james-pankiw/mren403-group10-portfolio-i/README.md

# MREN 403 Group 10 — Engineering Portfolio I

UAV launch for MakeFlyEasy Fighter on Zodiac Nautic PRO 7.  
Supervisors: Jonathan Gammell, Melissa Greeff.

**Start here:** `problem-definition.md` → `decisions/subsystem-validation.md` → `experiments/` → `design/`.

| Folder / file | Contents |
| --- | --- |
| `problem-definition.md` | Problem definition |
| `decisions/` | Validation plan, roles |
| `design/` | Subsystem design packages |
| `experiments/` | Wave / pitch simulation write-ups and plots |
| `references/` | Fighter and PRO 7 sources |
| `deliverables/` | Proposal PDF |
