james-pankiw/mren403-group10-portfolio-i/design/README.md

# Design

Folders match launcher subsystems. See `decisions/subsystem-validation.md` for what the prototype tests.
