james-pankiw/mren403-group10-portfolio-i/design/pitch-gate/README.md

# Pitch gate

Sensing, forecast, allow/refuse for launch on a pitching boat.

## Sears framing

Thomas Sears’s work on wave-driven boat motion (Queen’s / Marshall lab) sits behind the gate design. Chapter 4 of his thesis gives a short-horizon pitch forecast as a **time-only spectral mixture**. Our sims use that as two cosines fitted to recent pitch, which beats a naive rate-hold over a ~0.3 s rail window. Field IMU logs and Sears’s full wave-modelling code are still separate from what we run here.

## Artifacts

| File | Role |
| --- | --- |
| `pitch_sine_sim.py` | Two-cosine forecast vs rate hold |
| `pitch_gate_demo.py` | Interactive boat / scope / arm demo |
| `../../experiments/wave-pitch-simulation.md` | Write-up |
| `../../experiments/pitch-forecast-v2.1.png` | Forecast figure |

## Reference

Sears, T. M. C. (2026). *Spectral Analysis for Robotic Spatiotemporal Mapping* (Ph.D. thesis, Chapter 4). Queen’s University. https://queensu.scholaris.ca/items/ed41fb5e-f0e1-4573-935c-7e94e8f48fed
