james-pankiw/mren403-group10-portfolio-i/design/rails-structure/README.md

# Rails / structure

| File | Role |
| --- | --- |
| `Prototype Rails.docx` | Acrylic / PLA / Sasco strut trade → strut bed for the **prototype** |
| `Full Sized Rail.docx` | CNC aluminum vs stainless → **stainless** for full-size |

Prototype strut tests structure stability only; they do not lock full-size material.
