james-pankiw/mren403-group10-portfolio-i/design/carriage-release/README.md

# Carriage & release

Hold / brake / gripper clear for the rail launch axis.

| File | Role |
| --- | --- |
| `insitu-carriage.md` | Insitu SuperWedge concept → what we adopt for hold / brake / clear |

Prototype uses a football as fuselage stand-in. CAD and gripper detail still TBD.
