james-pankiw/mren403-group10-portfolio-i/design/launch-energy/README.md

# Launch energy

Band sizing and selection for the rail launch axis.

| File | Role |
| --- | --- |
| `Launcher Band Calculations.docx` | Energy / band sizing |
| `Launcher Band Decision.docx` | Band choice and rationale |
