james-pankiw/mren403-group10-portfolio-i/decisions/group-leads.md

# Group leads

MREN 403 Group 10. Technical ownership for design, prototype validation, and report sections.

| Lead | Heads |
| --- | --- |
| **James Pankiw** | Wave prediction; sensing; electronics (IMU, Pi, logging, wiring); report section on prediction/electronics |
| **Darcy Ryan** | Rails, frame, carriage structure; boat mount interface |
| **Ahrvin Raveendran** | Launch dynamics; energy delivery (bands/latch loads); actuation |
| **Jamison McCulloch-Cop** | Pitch stabilization; **CAD modelling for the final (full-size) design** |
