james-pankiw/mren403-group10-portfolio-i/references/fighter-hand-throw.md

# MakeFlyEasy Fighter, hand-throw

Copied 2026-10-07 from the manufacturer page: https://en.makeflyeasy.com/index.php/fighter-hand-throw/

The page is the source. A manual is still not in the repo. Do not fill launch speed, empty mass, or an acceleration limit from anywhere else without a citation.

## Stated on the page

| Item | Value |
| --- | --- |
| Layout | Conventional fixed-wing, hand-throw version |
| Material | EPO, EVA, carbon fiber, engineering plastics, etc. |
| Wingspan | 2430 mm |
| Fuselage length | 1450 mm |
| Fuselage height | 180 mm |
| Wing area | 72.5 dm² |
| Disassembly | Tool-less |
| Load compartment | 280 × 160 × 110 mm |
| Transport box | 1.25 m × 0.34 m × 0.49 m |
| Max. takeoff weight | < 7 kg |
| Max. payload | 1.5 kg |
| Take-off and landing | Hand-throw; parachute landing or slide landing |
| Practical lift height | 4000 m |
| Wind resistance | 50km (the page does not write km/h) |

## Useful conversions

These are arithmetic on the table above, not extra manufacturer data.

- Wing area 72.5 dm² = 0.725 m².
- At the takeoff-weight limit, wing loading is under \(7 / 0.725 \approx 9.7\,\mathrm{kg/m^2}\).
- If both limits apply at once, airframe plus everything except the 1.5 kg payload is under 5.5 kg.

## Not on the page

Hand-throw speed, stall speed, cruise speed, empty mass, motor, and any acceleration or g limit. The proposal’s 15 m/s and 4.6 g rail example stay assumed until a manual or a measurement supplies them. An 11 kg airframe is above the stated takeoff limit.
