james-pankiw/mren403-group10-portfolio-i/design/launch-energy/Launcher Band Calculations.docx

# Launcher Band Calculations: Prototype (5 kg) and Full Size (11.5 kg)

Final, 12 November 2026. These are the calculations behind every number in the companion report, Launcher Band Selection. Sections 1–4 are shared; Section 5 is the 5 kg prototype and Section 6 the 11.5 kg full-size MFE Fighter. All equations are editable Word equations.

## Where each report number comes from

Report figure | Prototype | Full size
Energy needed | 5.1 | 6.1
Strand count | 5.2 | 6.2
Exit speed, peak acceleration, pull | 5.3 | 6.3
Minimum rail length | 5.4 | 6.4
Time on the rail | 5.5 | 6.5
Rubber cost and cost per kJ | 5.6 | 6.6
Force per strand | 3 | 3
Usable energy per strand | 4 | 4
Simulation check and code | 7 | 7

## 1. Inputs

Symbol | Quantity | Value | Basis
m_(uav) | Launched mass | 5.0 kg prototype; 11.5 kg full size | Team; Fighter MTOW [1]
m_(cart) | Cart mass | 1.5 kg | Assumed
V_s | Fighter stall speed | 10 m/s | ArduPilot spec [1]
v_t | Target exit speed | 15 m/s (minimum 13 m/s) | 1.5 (1.3) × V_s
L | Rail length | 2.0 m | Design
s | Cart stroke | L − 0.2 = 1.8 m | 0.2 m for cart arrester
θ | Rail angle | 12° | Assumed
μ | Rail friction | 0.05 | Assumed
η | Energy recovered by latex | 0.85 | Assumed
L_0 | Unstretched strand length | L/2 = 1.0 m | Design
ρ | Latex density | 950 kg/m³ | SG 0.95 [2]
a_(max) | Acceleration limit | 10 g | Catapult design practice [3]
g | Gravity | 9.81 m/s² | —

Latex stress–strain curve (stress on the unstretched cross-section), linearly interpolated [4]:

Strain ε | 0 | 0.5 | 1 | 1.5 | 2 | 2.5 | 3 | 3.5 | 4
σ (psi) | 0 | 70 | 95 | 115 | 135 | 160 | 175 | 195 | 205

1 psi=6894.76 Pa,  sin12^(∘) =0.20791,  cos12^(∘) =0.97815,  sinθ+μcosθ=0.20791+0.05×0.97815=0.25682

## 2. Band geometry and strain

Strands run from an anchor at the rear of the rail, over a pulley at the front, and back to the cart. They are cut to half the rail length so they sit at 300% when cocked.

L_c =2L=2×2.0=4.0 m,  L_0 =(L_c)/4=1.0 m,  L_r =L+0.2=2.2 m

ε_c =(L_c -L_0)/(L_0)=(4.0-1.0)/1.0=3.0,  ε_r =(L_r -L_0)/(L_0)=(2.2-1.0)/1.0=1.2,  ε(x)=3.0-x

σ(1.2)=95+(1.2-1.0)/(1.5-1.0) (115-95)=103 psi

## 3. Force per strand

A=π/4(OD^2 -ID^2 ),  F=A σ(ε)

16 mm speargun rubber (OD 16 mm, ID 3.175 mm [5]):

A=0.785398×(256.00-10.081)=193.14 mm^2

F(100%)=193.14×10^(-6) ×95×6894.76=126.5 N

F(120%)=193.14×10^(-6) ×103×6894.76=137.2 N

F(200%)=193.14×10^(-6) ×135×6894.76=179.8 N

F(300%)=193.14×10^(-6) ×175×6894.76=233.0 N

14 mm speargun rubber (OD 14 mm, ID 3.175 mm [5]):

A=0.785398×(196.00-10.081)=146.02 mm^2

F(100%)=146.02×10^(-6) ×95×6894.76=95.6 N

F(120%)=146.02×10^(-6) ×103×6894.76=103.7 N

F(200%)=146.02×10^(-6) ×135×6894.76=135.9 N

F(300%)=146.02×10^(-6) ×175×6894.76=176.2 N

3/8 in ID surgical tubing (OD 12.7 mm, ID 9.525 mm):

A=0.785398×(161.29-90.726)=55.42 mm^2

F(100%)=55.42×10^(-6) ×95×6894.76=36.3 N

F(120%)=55.42×10^(-6) ×103×6894.76=39.4 N

F(200%)=55.42×10^(-6) ×135×6894.76=51.6 N

F(300%)=55.42×10^(-6) ×175×6894.76=66.9 N

## 4. Usable energy per strand

E_s =η A L_0 ∫_1.2^3.0 σ dε

Segment | Δε | Average σ (psi) | Area (psi)
1.2 → 1.5 | 0.3 | (103 + 115) / 2 = 109 | 32.70
1.5 → 2 | 0.5 | (115 + 135) / 2 = 125 | 62.50
2 → 2.5 | 0.5 | (135 + 160) / 2 = 147.5 | 73.75
2.5 → 3 | 0.5 | (160 + 175) / 2 = 167.5 | 83.75
Total | 1.8 | | 252.70

∫_1.2^3.0 σ dε=252.70×6894.76=1.7423×10^6 J/m^3

E_(s,16mm) =0.85×193.14×10^(-6) ×1.0×1.7423×10^6 =286.0 J

E_(s,14mm) =0.85×146.02×10^(-6) ×1.0×1.7423×10^6 =216.3 J

E_(s,surg) =0.85×55.42×10^(-6) ×1.0×1.7423×10^6 =82.1 J

## 5. Prototype: 5.0 kg

### 5.1 Energy needed

m=m_(uav) +m_(cart) =5.0+1.5=6.5 kg

E_k =1/2mv_t^2 =1/2×6.5×15^2 =731.2 J

W_g =mgsinθ s=6.5×9.81×0.20791×1.8=23.9 J

W_f =μmgcosθ s=0.05×6.5×9.81×0.97815×1.8=5.6 J

E_(req) =E_k +W_g +W_f =731.2+23.9+5.6=760.7 J

### 5.2 Strand count

First estimate n ≈ E_req / E_s, then take the fewest strands whose exit speed (Section 5.3) reaches 15 m/s:

16 mm speargun rubber: n≈760.7/286.0=2.66;  v(2)=12.79<15, v(3)=15.74≥15 → n=3

14 mm speargun rubber: n≈760.7/216.3=3.52;  v(3)=13.65<15, v(4)=15.80≥15 → n=4

3/8 in ID surgical tubing: n≈760.7/82.1=9.27;  v(8)=13.74<15, v(10)=15.39≥15 → n=10

Surgical tubing goes in pairs (one loop = two strands).

### 5.3 Exit speed, peak acceleration and pull

m_(eff) =m_(uav) +m_(cart) +1/3nρAL_0 ,  v_(exit) =√((2[nE_s -m_(eff) g s(sinθ+μcosθ)])/(m_(eff))),  a_(peak) =(ηnAσ(3.0))/(m_(eff))-g(sinθ+μcosθ)

16 mm speargun rubber, 3 strands:

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

16 mm speargun rubber, 6 strands, worked in full:

x=0.3: ∫_2.7^3.0 σ dε=0.3×170.5=51.15 psi

W=0.85×6×193.14×10^(-6) ×51.15×6894.76=347.4 J,  v(0.3)=√((2(347.4-10.1))/13.367)=7.10 m/s

x=0.6: ∫_2.4^3.0 σ dε=0.1×157.5+0.5×167.5=99.50 psi

W=0.85×6×193.14×10^(-6) ×99.50×6894.76=675.8 J,  v(0.6)=√((2(675.8-20.2))/13.367)=9.90 m/s

x=0.9: ∫_2.1^3.0 σ dε=0.4×150.0+0.5×167.5=143.75 psi

W=0.85×6×193.14×10^(-6) ×143.75×6894.76=976.3 J,  v(0.9)=√((2(976.3-30.3))/13.367)=11.90 m/s

x=1.2: ∫_1.8^3.0 σ dε=0.2×131.0+0.5×147.5+0.5×167.5=183.70 psi

W=0.85×6×193.14×10^(-6) ×183.70×6894.76=1247.6 J,  v(1.2)=√((2(1247.6-40.4))/13.367)=13.44 m/s

x=1.5: ∫_1.5^3.0 σ dε=0.5×125.0+0.5×147.5+0.5×167.5=220.00 psi

W=0.85×6×193.14×10^(-6) ×220.00×6894.76=1494.2 J,  v(1.5)=√((2(1494.2-50.5))/13.367)=14.70 m/s

x=1.8: ∫_1.2^3.0 σ dε=0.3×109.0+0.5×125.0+0.5×147.5+0.5×167.5=252.70 psi

W=0.85×6×193.14×10^(-6) ×252.70×6894.76=1716.2 J,  v(1.8)=√((2(1716.2-60.6))/13.367)=15.74 m/s

t=0.0845+0.0353+0.0275+0.0237+0.0213+0.0197=0.212 s

Other bands, same steps:

Band | Strands | v at 0.3 / 0.6 / 0.9 / 1.2 / 1.5 / 1.8 m (m/s) | Time on rail
16 mm speargun rubber | 6 | 7.10 / 9.90 / 11.90 / 13.44 / 14.70 / 15.74 | 0.212 s
14 mm speargun rubber | 8 | 7.13 / 9.94 / 11.94 / 13.49 / 14.76 / 15.80 | 0.211 s
3/8 in ID surgical tubing | 20 | 6.95 / 9.69 / 11.63 / 13.14 / 14.37 / 15.39 | 0.217 s

### 6.6 Rubber cost

L_(buy) =(1.15 n L_0)/0.3048 ft,  Cost per kJ=(L_(buy) ×price per ft)/(n E_s /1000)

Rubber | n | L_buy (ft) | Set cost | Cost per kJ
Primeline 16 mm speargun [6] | 6 | 1.15 × 6 / 0.3048 = 22.64 | 23 ft: $103.50 | (22.64 × 4.5) / (6 × 286.0 / 1000) = $59
Rob Allen 16 mm speargun [7] | 6 | 1.15 × 6 / 0.3048 = 22.64 | 23 ft: $108.56 | (22.64 × 4.72) / (6 × 286.0 / 1000) = $62
Kent 16 mm speargun [5] | 6 | 1.15 × 6 / 0.3048 = 22.64 | 23 ft: $120.75 | (22.64 × 5.25) / (6 × 286.0 / 1000) = $69
Primeline 14 mm speargun [5] | 8 | 1.15 × 8 / 0.3048 = 30.18 | 31 ft: $140.74 | (30.18 × 4.54) / (8 × 216.3 / 1000) = $79
3/8 in ID x 1/16 in wall surgical tubing [8] | 20 | 1.15 × 20 / 0.3048 = 75.46 | one 100 ft box: $112.25 | (75.46 × 1.123) / (20 × 82.1 / 1000) = $52

## 7. Simulation model

The launch is also simulated by stepping the equation of motion through time. This checks the energy-method exit speeds in 5.3 and 6.3, gives the time on the rail directly, and is the model to re-run once the rubber has been pull-tested.

Equation of motion along the rail, with x the cart position from the cocked point:

m_(eff) x=η n A σ(ε(x))-m_(eff) g(sinθ+μcosθ),  ε(x)=(2L-x)/(L_0)-1

Integration (semi-implicit Euler) from rest at x = 0 until the cart reaches the end of the stroke, x = s:

x_i =(η n A σ(ε(x_i )))/(m_(eff))-g(sinθ+μcosθ),  v_(i+1) =v_i +x_i Δt,  x_(i+1) =x_i +v_(i+1) Δt,  Δt=10^(-5) s

Exit speed is v when x reaches s, time on the rail is the number of steps × Δt, and peak acceleration is the largest acceleration over the stroke (at x = 0).

First step, 16 mm prototype (3 strands), to show the update:

x_0 =(0.85×3×193.14×10^(-6) ×175×6894.76)/6.683-9.81×0.25682=86.40 m/s^2

v_1 =0+86.40×10^(-5) =0.000864 m/s,  x_1 =0+0.000864×10^(-5) =0.000864×10^(-5) m

Results: simulation against the energy method

Case | Band | Strands | Exit speed, energy method | Exit speed, simulation | Time on rail, simulation | Peak accel.
Prototype (5.0 kg) | 16 mm speargun rubber | 3 | 15.74 m/s | 15.74 m/s | 0.211 s | 8.8 g
Prototype (5.0 kg) | 14 mm speargun rubber | 4 | 15.80 m/s | 15.80 m/s | 0.210 s | 8.9 g
Prototype (5.0 kg) | 3/8 in ID surgical tubing | 10 | 15.39 m/s | 15.39 m/s | 0.216 s | 8.4 g
Full size (11.5 kg) | 16 mm speargun rubber | 6 | 15.74 m/s | 15.74 m/s | 0.211 s | 8.8 g
Full size (11.5 kg) | 14 mm speargun rubber | 8 | 15.80 m/s | 15.80 m/s | 0.210 s | 8.9 g
Full size (11.5 kg) | 3/8 in ID surgical tubing | 20 | 15.39 m/s | 15.39 m/s | 0.216 s | 8.4 g

The two methods agree to within 0.01 m/s, and the simulated times match the step sums in 5.5 and 6.5 to within 0.001 s.

Python code. Change the inputs at the top and re-run; replace sig with your own pull-test results.

import numpy as np, math

# ---- inputs ----
PSI, g = 6894.76, 9.81
eps = [0, .5, 1, 1.5, 2, 2.5, 3, 3.5, 4] # strain
sig = [0, 70, 95, 115, 135, 160, 175, 195, 205] # psi
theta, mu, eta, rho = math.radians(12), 0.05, 0.85, 950
m_cart = 1.5 # kg

def launch(m_uav, n, OD, ID, L=2.0, dt=1e-5):
"""Bungee launch on a rail of length L (m).
n strands, tube OD/ID in mm. Returns exit speed (m/s),
peak acceleration (g) and time on the rail (s)."""
A = math.pi/4*(OD**2 - ID**2)*1e-6 # cross-section, m^2
L0 = L/2 # strand length, m
s = L - 0.2 # stroke, m
m = m_uav + m_cart + n*rho*A*L0/3 # effective mass, kg
k = math.sin(theta) + mu*math.cos(theta)
x = v = t = 0.0; a_max = 0.0
while x < s:
e = (2*L - x)/L0 - 1 # strain at position x
F = eta*n*A*np.interp(e, eps, sig)*PSI # band force, N
a = F/m - g*k # acceleration, m/s^2
a_max = max(a_max, a)
v += a*dt; x += v*dt; t += dt
return v, a_max/g, t

# prototype (5 kg) and full size (11.5 kg), 16 mm rubber
print(launch(5.0, 3, 16, 3.175)) # ~ (15.74, 8.8, 0.211)
print(launch(11.5, 6, 16, 3.175)) # ~ (15.74, 8.8, 0.211)

## References

[1] ArduPilot Dev Team, “MakeFlyEasy Fighter Hand Throw,” ArduPilot Documentation. Accessed: Nov. 11, 2026. [Online]. Available: https://ardupilot.org/dev/docs/common-makeflyeasy-fighter-hand-throw.html

[2] Blue Tuna Spearfishing, “Primeline premium small I.D. speargun band rubber tubing 9/16in (14mm), 5/8in (16mm), 11/16in (17.5mm),” Blue Tuna Spearfishing. Accessed: Nov. 11, 2026. [Online]. Available: https://bluetunaspearfishing.com/products/primeline-premium-small-i-d-speargun-band-rubber-tubing-9-16in14mm-5-8in16mm-11-16in17-5mm

[3] Z. Novaković, N. Medar, and L. Mitrović, “Increasing launch capability of a UAV bungee catapult,” Scientific Technical Review, vol. 64, no. 4, pp. 17–26, 2014. [Online]. Available: https://scindeks-clanci.ceon.rs/data/pdf/1820-0206/2014/1820-02061404017N.pdf

[4] Physics Forums, “Force required to stretch a rubber band to a certain diameter,” Physics Forums, Jun. 2019. Accessed: Nov. 11, 2026. [Online]. Available: https://www.physicsforums.com/threads/force-required-to-stretch-a-rubber-band-to-a-certain-diameter.972780/

[5] Blue Tuna Spearfishing, “Bulk 9/16 (14mm)–5/8 (16mm)–17.5mm inch latex speargun power band rubber tubing,” Blue Tuna Spearfishing. Accessed: Nov. 11, 2026. [Online]. Available: https://bluetunaspearfishing.com/products/bulk-14mm-16mm-17-5mm-9-16-5-8-3-4-inch-latex-speargun-power-band-rubber-tubing

[6] Westside Dive & Tackle, “16mm Black/Amber Primline speargun rubber | per foot,” Westside Dive & Tackle. Accessed: Nov. 11, 2026. [Online]. Available: https://westsidedive.com/products/16mm-black-amber-primline-speargun-rubber-per-foot

[7] House of Scuba, “Rob Allen bulk rubber spear gun for bands 5/8in 16mm sold per foot,” House of Scuba. Accessed: Nov. 11, 2026. [Online]. Available: https://www.houseofscuba.com/products/spgun131

[8] Latex-Tubing.com, “Surgical latex rubber tubing, 3/8 I.D. x 1/16 W. – 1/2 O.D.,” Latex-Tubing.com. Accessed: Nov. 11, 2026. [Online]. Available: https://www.latex-tubing.com/lrt038116.html
