james-pankiw/mren403-group10-portfolio-i/design/launch-energy/Launcher Band Decision.docx

# Launcher Band Selection

2 m bungee launcher for the MakeFlyEasy Fighter (hand-launch version) · 12 November 2026

## Summary

Use 16 mm latex speargun rubber in 1.0 m strands, pre-stretched to 300%: 3 strands for the 5 kg prototype, 6 for the 11.5 kg full size. Both launch at 15.7 m/s on the 2 m rail with a peak of 8.8 g, and need at least 1.83 m of rail for 15 m/s. Rubber costs $54.00 for the prototype and $103.50 for the full size.

All figures are modelled; every peak acceleration is under the 10 g limit. The working is in Launcher Band Calculations. Pull-test the rubber you buy before finalising.

## Requirements

Item | Prototype | Full size
Launched mass | 5.0 kg test mass | 11.5 kg (Fighter MTOW) [1]
Cart mass | 1.5 kg | 1.5 kg
Target exit speed | 15 m/s (min. 13) | 15 m/s (min. 13)
Energy needed | 761 J | 1,521 J
Rail / stroke | 2.0 m / 1.8 m | 2.0 m / 1.8 m
Acceleration limit [2] | 10 g | 10 g

Target speed is 1.5 × the Fighter’s 10 m/s stall speed [1].

## Band options

Option | Verdict
16 mm latex speargun rubber | Recommended: fewest strands, built for repeated high-energy pulls [3]
14 mm latex speargun rubber | Works; one or two more strands than 16 mm, costs more
3/8” ID latex surgical tubing | Cheapest per kJ at full size, but over 3× as many strands
MIL-C-5651 shock cord | Durable, but only 120–140% stretch [4] and no published force curve
Silicone / EPDM | Weather-resistant, too little stretch and energy [5]

## Force per strand

Band | Cross-section | At 120% (release) | At 200% | At 300% (cocked) | Usable energy, 1.0 m strand
16 mm speargun rubber | 193 mm² | 137 N | 180 N | 233 N | 286 J
14 mm speargun rubber | 146 mm² | 104 N | 136 N | 176 N | 216 J
3/8 in ID surgical tubing | 55 mm² | 39 N | 52 N | 67 N | 82 J

## Launch performance on the 2 m rail

The full size uses exactly twice the prototype’s strands for twice the moving mass, so speed, acceleration and minimum rail length are the same.

Band | Strands (proto / full) | Pull cocked (proto / full) | Pull at release (proto / full) | Exit speed | Peak accel. | Time on rail | Min. rail, 13 / 15 m/s
16 mm speargun rubber | 3 / 6 | 699 / 1,398 N | 411 / 823 N | 15.7 m/s | 8.8 g | 0.21 s | 1.40 / 1.83 m
14 mm speargun rubber | 4 / 8 | 705 / 1,409 N | 415 / 830 N | 15.8 m/s | 8.9 g | 0.21 s | 1.39 / 1.81 m
3/8 in ID surgical tubing | 10 / 20 | 669 / 1,337 N | 394 / 787 N | 15.4 m/s | 8.4 g | 0.22 s | 1.46 / 1.91 m

Minimum rail lengths keep the strand counts and 300% pre-stretch, with strands cut to half the rail length. Add 10–15% margin: a 2 m rail meets that for 15 m/s.

## Prices and where to buy

USD unless noted, before shipping, brokerage and duty. Set length = strands × 1.0 m + 15% for knots and fittings.

Rubber | Price | Prototype set | Full-size set | Where to buy
Primeline 16 mm speargun | $4.50/ft | 3 strands, 12 ft: $54.00 | 6 strands, 23 ft: $103.50 | Westside Dive & Tackle [6]
Rob Allen 16 mm speargun | $4.72/ft | 3 strands, 12 ft: $56.64 | 6 strands, 23 ft: $108.56 | House of Scuba [7]
Kent 16 mm speargun | $5.25/ft | 3 strands, 12 ft: $63.00 | 6 strands, 23 ft: $120.75 | Blue Tuna Spearfishing [8]
Primeline 14 mm speargun | $4.54/ft | 4 strands, 16 ft: $72.64 | 8 strands, 31 ft: $140.74 | Blue Tuna Spearfishing [8]
3/8 in ID x 1/16 in wall surgical tubing | $1.85/ft; 50 ft $65.40; 100 ft $112.25 | 10 strands, one 50 ft reel: $65.40 | 20 strands, one 100 ft box: $112.25 | Latex-Tubing.com [9]
MIL-C-5651D 1/2” shock cord | CA$4.82/ft | needs pull test | needs pull test | Aircraft Spruce Canada [10]

## Durability and safety

- Cold: latex launches slower when cold; keep bands warm and a spare strand on hand [11].
- Break-in: cycle new bands 10–20 times before calibrating [12].
- Storage: never under tension, out of sunlight, below 38 °C; replace every 3–5 years [13].
- Abrasion: sleeve rubber at pulleys and anchors [5].
- Safety: safety pin plus remote release, cart arrester, eye protection, keep-out zone; inspect bands before every launch.

## Test plan

1. Pull-test one 1.0 m strand at 100%, 200% and 300%.
2. Update the calculations with measured force and actual cart mass.
3. Launch the 5 kg prototype with 1, 2, then 3 strands; measure exit speed on video.
4. Calibrate the model, then scale to 6 strands for the full size.

## Assumptions

1.5 kg cart, 12° rail, 5% friction, 85% energy recovery, 10 g limit [2], speargun rubber 1/8” ID [8], latex stress–strain data from published tubing tests [14].

## References

[1] ArduPilot Dev Team, “MakeFlyEasy Fighter Hand Throw,” ArduPilot Documentation. Accessed: Nov. 11, 2026. [Online]. Available: https://ardupilot.org/dev/docs/common-makeflyeasy-fighter-hand-throw.html

[2] Z. Novaković, N. Medar, and L. Mitrović, “Increasing launch capability of a UAV bungee catapult,” Scientific Technical Review, vol. 64, no. 4, pp. 17–26, 2014. [Online]. Available: https://scindeks-clanci.ceon.rs/data/pdf/1820-0206/2014/1820-02061404017N.pdf

[3] Blue Tuna Spearfishing, “Primeline premium small I.D. speargun band rubber tubing 9/16in (14mm), 5/8in (16mm), 11/16in (17.5mm),” Blue Tuna Spearfishing. Accessed: Nov. 11, 2026. [Online]. Available: https://bluetunaspearfishing.com/products/primeline-premium-small-i-d-speargun-band-rubber-tubing-9-16in14mm-5-8in16mm-11-16in17-5mm

[4] Lexco Cable Mfg., “MIL-C-5651 Type I,” Lexco Cable Product Catalog. Accessed: Nov. 11, 2026. [Online]. Available: https://catalog.lexcocable.com/viewitems/-components-fibertex-rolls-military-spec-1/ents-fibertex-rolls-military-spec-type-i-1

[5] RCM&E, “Flying start,” Model Flying. Accessed: Nov. 11, 2026. [Online]. Available: https://www.modelflying.co.uk/?p=3029

[6] Westside Dive & Tackle, “16mm Black/Amber Primline speargun rubber | per foot,” Westside Dive & Tackle. Accessed: Nov. 11, 2026. [Online]. Available: https://westsidedive.com/products/16mm-black-amber-primline-speargun-rubber-per-foot

[7] House of Scuba, “Rob Allen bulk rubber spear gun for bands 5/8in 16mm sold per foot,” House of Scuba. Accessed: Nov. 11, 2026. [Online]. Available: https://www.houseofscuba.com/products/spgun131

[8] Blue Tuna Spearfishing, “Bulk 9/16 (14mm)–5/8 (16mm)–17.5mm inch latex speargun power band rubber tubing,” Blue Tuna Spearfishing. Accessed: Nov. 11, 2026. [Online]. Available: https://bluetunaspearfishing.com/products/bulk-14mm-16mm-17-5mm-9-16-5-8-3-4-inch-latex-speargun-power-band-rubber-tubing

[9] Latex-Tubing.com, “Surgical latex rubber tubing, 3/8 I.D. x 1/16 W. – 1/2 O.D.,” Latex-Tubing.com. Accessed: Nov. 11, 2026. [Online]. Available: https://www.latex-tubing.com/lrt038116.html

[10] Aircraft Spruce Canada, “Shock cord,” Aircraft Spruce Canada Catalog. Accessed: Nov. 11, 2026. [Online]. Available: https://www.aircraftspruce.ca/catalog/lgpages/shockcord.php

[11] DIY Drones, “The most economic method for sUAS launch,” DIY Drones: Agricultural UAVs. Accessed: Nov. 11, 2026. [Online]. Available: https://diydrones.com/group/agricultural-uavs/forum/the-most-economic-method-for-suas-launch

[12] R. M. Patterson, C. W. Stegink Jansen, H. A. Hogan, and M. D. Nassif, “Material properties of Thera-Band tubing,” Physical Therapy, vol. 81, no. 8, pp. 1437–1445, Aug. 2001.

[13] Walker Rubber, “The ageing of rubber,” Walker Rubber Knowledge Hub. Accessed: Nov. 11, 2026. [Online]. Available: https://www.walker-rubber.co.uk/knowledge-hub/the-ageing-of-rubber-366

[14] Physics Forums, “Force required to stretch a rubber band to a certain diameter,” Physics Forums, Jun. 2019. Accessed: Nov. 11, 2026. [Online]. Available: https://www.physicsforums.com/threads/force-required-to-stretch-a-rubber-band-to-a-certain-diameter.972780/
