james-pankiw/mren403-group10-portfolio-i/design/pitch-stabilization/UAV_launch_Actuator_values.pdf

## Actuator Force Requirements for Rail Control System

Jamison McCulloch-Cop, Reviewed By Darcy Ryan

November 13, 2026

## 1 System Definition

Define the following parameters:

L1 = Length of beam
L2 = Length of attached object m1 = Mass of beam
m2 = Mass of attached object
rf = Actuator attachment distance from pivot ∆θ = Required angular displacement

t = Desired motion time
g = Gravitational acceleration
∆z = Linear distance

z˙ = Linear speed

The beam rotates about the left-hand pivot.

1

## 2 Free Body Diagram

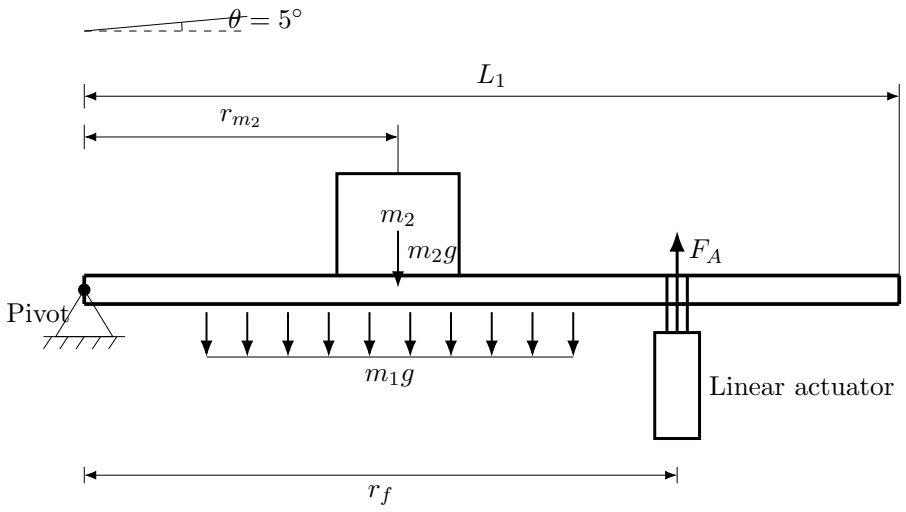
[picture p13: figure]
Pivot; Linear actuator

where

rm1 = Distance from pivot to beam center of mass rm2 = Distance from pivot to object center of mass

## 3 Gravitational Torque

The torque due to gravity is

τg = m1grm1

cos θ + m2grm2

cos θ

The maximum gravitational torque occurs at

θ = 0

giving

τg,max = m1grm1 + m2grm2

2

## 4 Angular Acceleration

Assume a symmetric motion profile where the beam starts and ends at rest, accelerating for the first half of the motion and decelerating for the second half.
The angular displacement is

∆θ =

αt²

4
Thus,

α =

4∆θ
t

2

## 5 Rotational Inertia

The beam inertia about the rail pivot (uniform rod, pivot at one end) is

I1 =

1
3

m1L

2
1

The payload must be taken about the same pivot. If the payload centre of mass lies a distance rm2

from the pivot, the parallel-axis contribution is

I2 = I2,cm + m2r

2
m2

For a compact aircraft, I2,cm is often small compared with m2r

2
m2

, so

I2 ≈ m2r

2
m2
is a useful lower-bound model. Using only 1
3m2L

2/2 about the payload’s own end (and omitting m2r

2
m2

) understates inertia when the aircraft sits far out on the rail.
Therefore,
IT = I1 + I2 = I1 + I2,cm + m2r

2
m2

## 6 Acceleration Torque

The torque required to accelerate the rotating system is

τa = ITα

Substituting the angular acceleration,

τa = IT

(︃
4∆θ
t

2

)︃

3

## 7 Total Required Torque

The maximum torque requirement occurs at the beginning of motion where gravity torque is largest and angular acceleration is applied.

τT = τg,max + τa

Substituting previous expressions,

τT = m1grm1 + m2grm2 + IT

(︃
4∆θ
t

2

)︃

## 8 Actuator Force

If the actuator force acts perpendicular to the beam at a distance rf from the pivot,
τA = FArf

Therefore,

FA =

τT
rf

Substituting for total torque,

FA =

m1grm1 + m2grm2 + IT

(︁

4∆θ
t

2

)︁

rf

More generally, if the actuator force is not perpendicular to the beam,

τA = FArf sin ϕ

and
FA =

τT
rf sin ϕ

where ϕ is the angle between the actuator force vector and the beam.

## 9 Linear Distance and Speed

For a vertical actuator mounted beneath the attachment point, the vertical displacement of the attachment point is

∆z = rf sin(∆θ)

4

The corresponding average linear speed is

z˙ =

∆z
t

It is important to note that ∆z represents the vertical motion of the attachment point. The true actuator stroke should be determined from the actuator mounting geometry and may differ from this value if the actuator does not remain vertical throughout the motion.

## 10 Safety Factor

Including a design safety factor Ns,

Fdesign = NsFA

where typically
Ns = 1.5–3

depending on the application.

## 11 Ball Screw Motor Requirements

Let

FA = Required actuator force
Ls = Ball screw lead (linear travel per revolution)

η = Ball screw efficiency

Tm = Required motor torque
n = Required motor rotational speed

The ball screw converts motor rotation into linear motion. The required motor torque is

Tm =

FALs
2πη

where

- FA is the actuator force,
- Ls is the ball screw lead,

5

- η is the mechanical efficiency of the ball screw.

The required motor speed is obtained from the actuator linear speed:

n =

z˙
Ls

where n is expressed in revolutions per second. Converting to revolutions per minute (RPM),

nRPM = 60 (︃
z˙
Ls

)︃

The mechanical power required from the motor is

Pm = Tmω

where

ω = 2πn

is the motor angular velocity. Equivalently,

Pm =

FAz˙
η

which provides a useful verification of the motor sizing calculations.

## 12 Notes on Implementation

- Use a consistent definition of θ (e.g. θ = 0 horizontal) when evaluating τg.
- For a triangular velocity profile, peak linear speed is about twice the average ˙z = ∆z/t; size motor RPM from the peak unless a softer profile is specified.
- Prototype masses (∼ 5 kg stand-in) and full-size Fighter mass (< 7 kg MTOW) must not be mixed with outdated placeholders (e.g. 11 kg).
- rm2
is the distance from the rail pivot to the payload centre of mass, not L2/2 unless the payload is actually centred that close to the pivot.

6
