james-pankiw/mren403-group10-portfolio-i/design/pitch-stabilization/ISV57T-180S_Torque_Speed_Curve.pdf

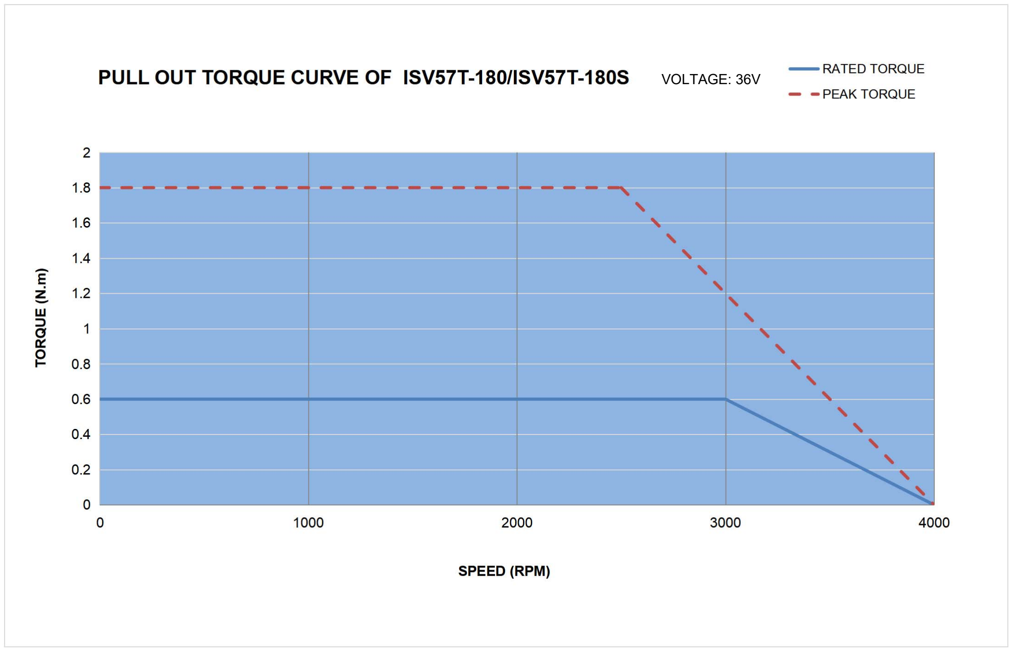
[picture p14: page 1]

VOLTAGE: 36V
