james-pankiw/mren403-group10-portfolio-i/design/pitch-stabilization/nema-23-stepper-motor-specs.pdf

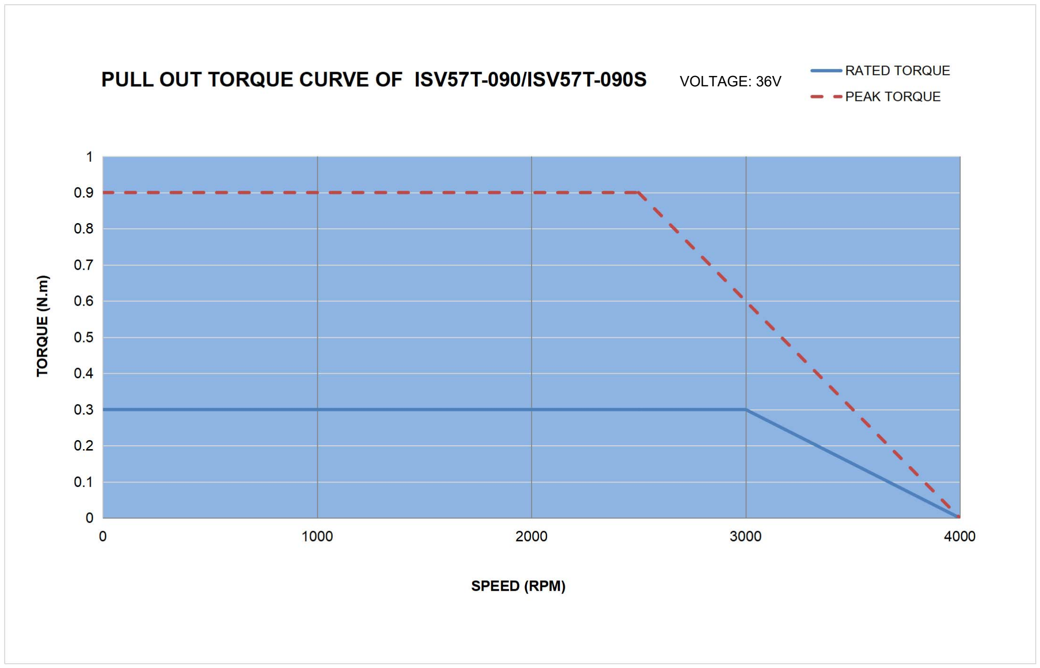
[picture p15: page 1]

VOLTAGE: 36V
