james-pankiw/mren403-group10-portfolio-i/design/assembly-cad/Luancher Assy V1.SLDASM

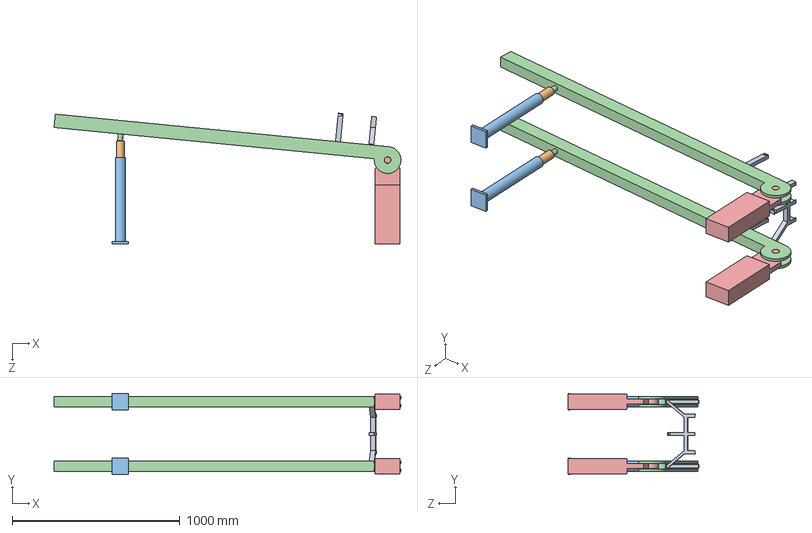
[picture p16: CAD file, 2026-11-12]
design/assembly-cad/Luancher Assy V1.SLDASM
2070.4 x 485.0 x 780.0 mm
Rotated Base V1 x 2
Rail Base V1 x 2
Actuated Base V1 x 2
Actuated Shaft V1 x 2
Mount V1
