james-pankiw/mren403-group10-portfolio-i/design/assembly-cad/Mount V1.SLDPRT

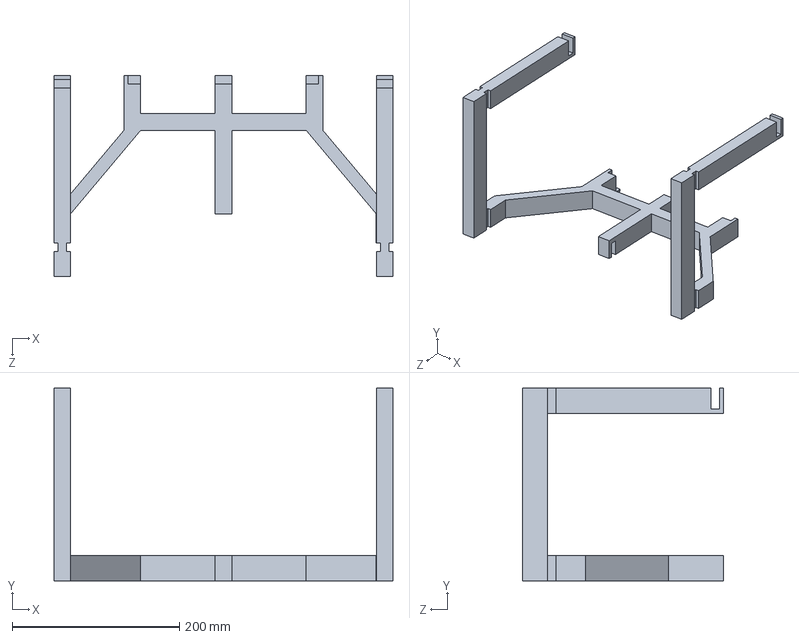
[picture p17: CAD file, 2026-11-12]
design/assembly-cad/Mount V1.SLDPRT
405.0 x 230.0 x 240.0 mm
