james-pankiw/mren403-group10-portfolio-i/design/assembly-cad/Rail Base V1.SLDPRT

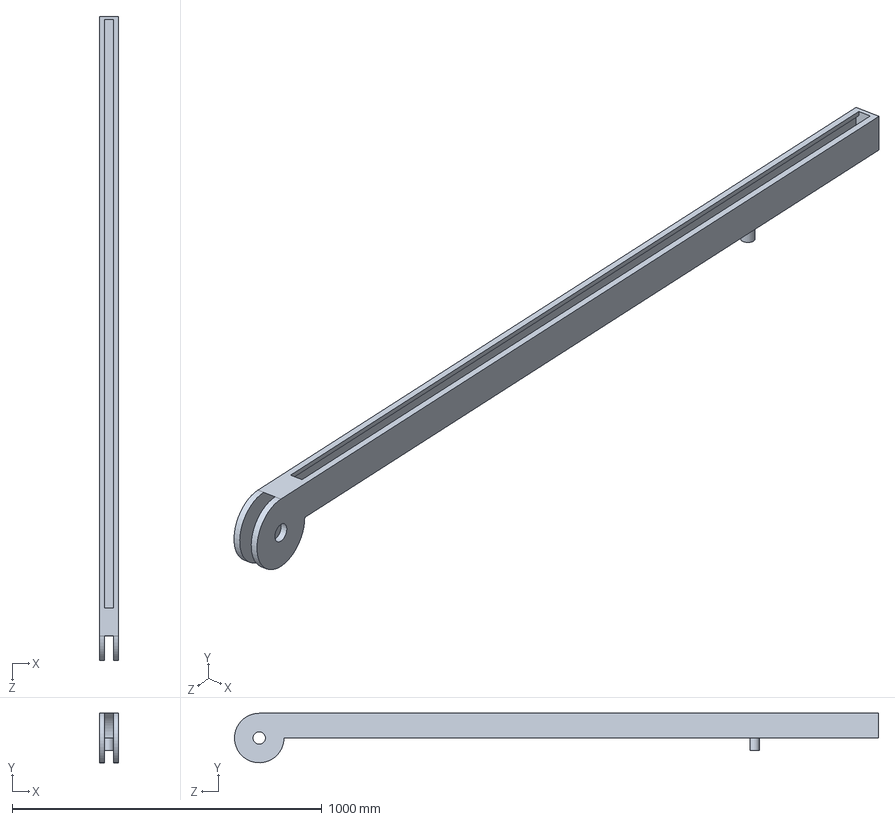
[picture p18: CAD file, 2026-11-12]
design/assembly-cad/Rail Base V1.SLDPRT
60.0 x 159.9 x 2079.9 mm
