james-pankiw/mren403-group10-portfolio-i/design/assembly-cad/Actuated Base V1.SLDPRT

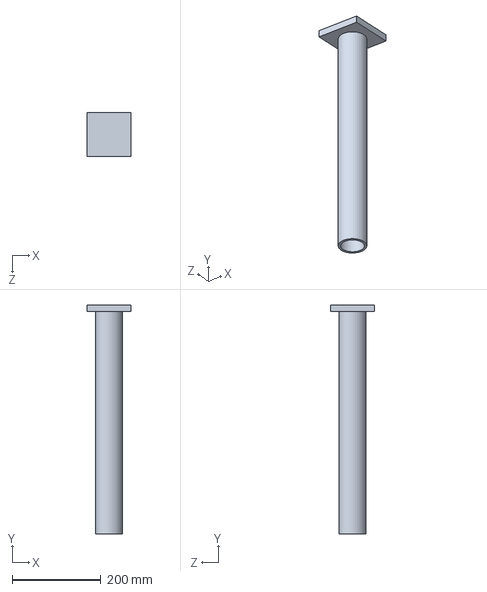
[picture p19: CAD file, 2026-11-12]
design/assembly-cad/Actuated Base V1.SLDPRT
100.0 x 515.0 x 100.0 mm
