james-pankiw/mren403-group10-portfolio-i/design/assembly-cad/Actuated Shaft V1.SLDPRT

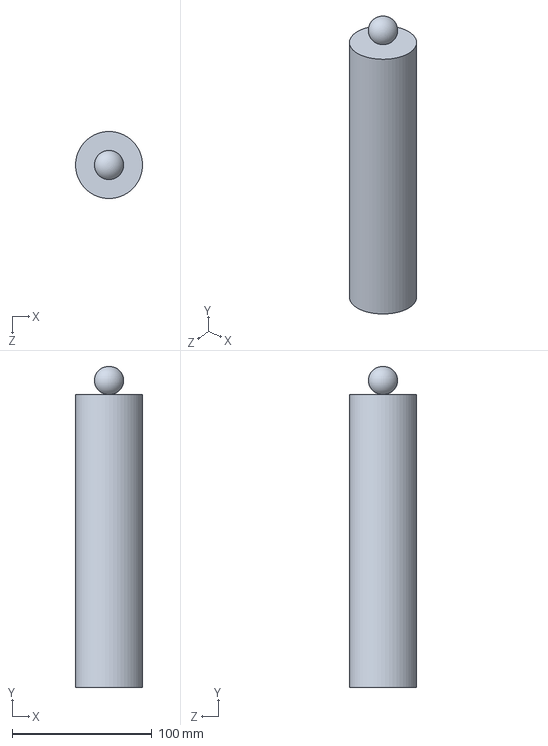
[picture p20: CAD file, 2026-11-12]
design/assembly-cad/Actuated Shaft V1.SLDPRT
48.0 x 230.0 x 48.0 mm
