james-pankiw/mren403-group10-portfolio-i/design/assembly-cad/Rotated Base V1.SLDPRT

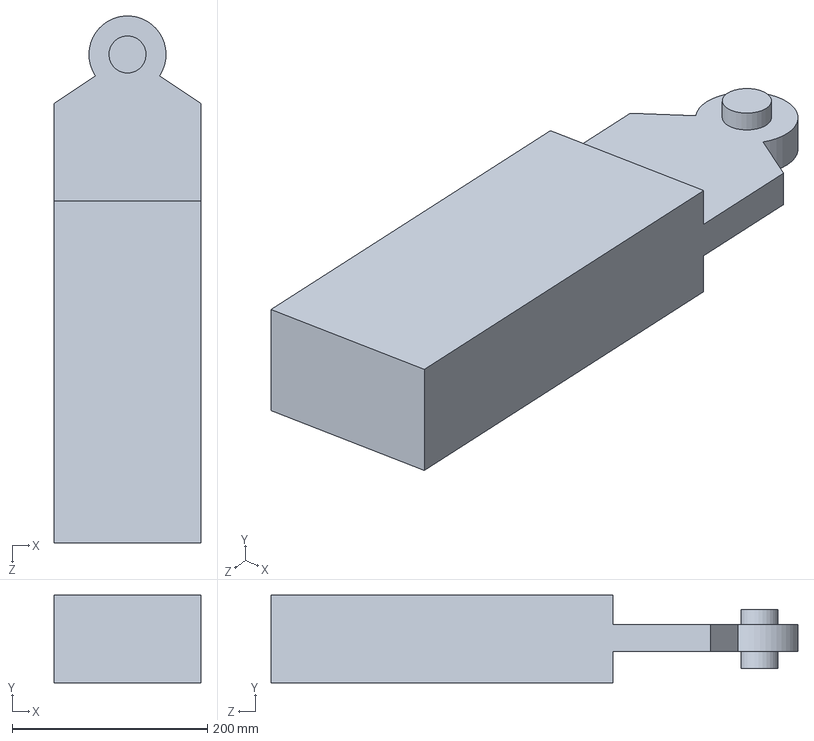
[picture p21: CAD file, 2026-11-12]
design/assembly-cad/Rotated Base V1.SLDPRT
150.0 x 90.0 x 539.4 mm
