james-pankiw/mren403-group10-portfolio-i/(list of files, cad)

Other CAD files:
design/assembly-cad/Luancher Assy V1.SLDDRW
