james-pankiw/mren403-group10-portfolio-i/design/assembly-cad/README.md

Tracking for current verison changes to cad files 

Luancher Assy V 1.0
- total assembly of all part as a visual example, no parts or  dimentions are finilized
  
Rotated Base V 1.0
- intial mock up of the hinged based attached to the boat,
  
Actuated Shaft V 1.0
- portion of front cylinder that moves to actutate the end of luancher for angle stability
  
Mount V 1.0
- where the UAV is mounted to and portion that slides along the rail
  
Actuated Base V 1.0
- the front base that holds in place while the actuated shaft moves (attached to boat at front)
  
Rail Base V 1.0
- the rail the mount slides along
