james-pankiw/mren403-group10-portfolio-i/experiments/pitch-forecast-v2.1.png

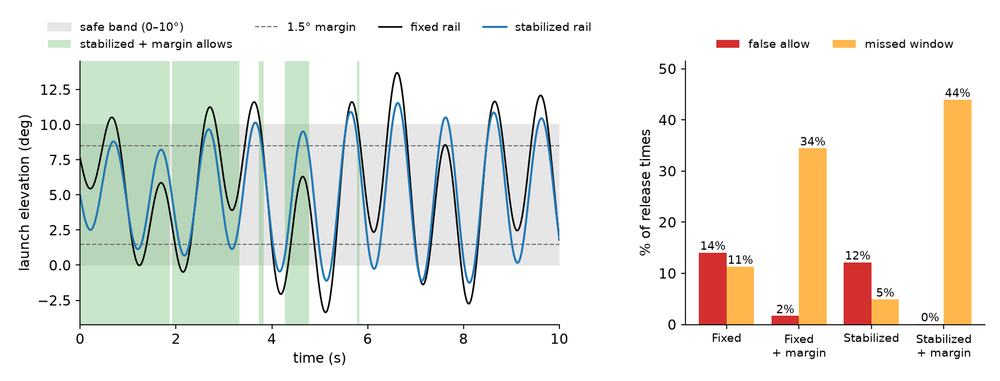
experiments/pitch-forecast-v2.1.png
