james-pankiw/mren403-group10-portfolio-i/experiments/pitch-from-wave-slope.png

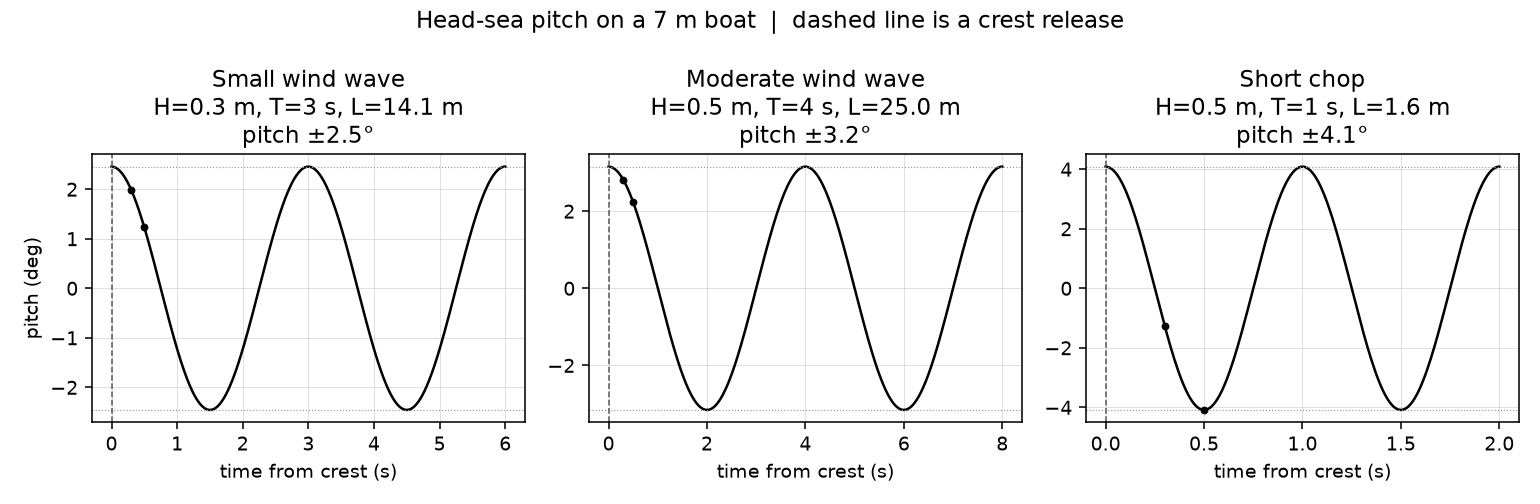
experiments/pitch-from-wave-slope.png
