james-pankiw/mren403-group10-portfolio-i/(commit log)

2026-11-12 Initial Engineering Portfolio I snapshot for MREN 403 Group 10.
    [Actuated Base V1.SLDPRT, Actuated Shaft V1.SLDPRT, Luancher Assy V1.SLDASM, Luancher Assy V1.SLDDRW, Mount V1.SLDPRT, Rail Base V1.SLDPRT, Rotated Base V1.SLDPRT]
2026-11-12 Reshape design/ around launcher subsystems; tone down README.
    [Actuated Base V1.SLDPRT, Actuated Shaft V1.SLDPRT, Luancher Assy V1.SLDASM, Luancher Assy V1.SLDDRW, Mount V1.SLDPRT, Rail Base V1.SLDPRT, Rotated Base V1.SLDPRT]
2026-11-13 Replace raw Jamison actuator uploads with cleaned .tex sources and corrected sizing script.
2026-11-13 Omit rail material comparison from portfolio snapshot.
2026-11-13 Drop meeting notes and redundant pitch/actuator/rail artifacts; add Insitu carriage writeup.
2026-11-13 Fix rails-structure paths in validation plan; add Sears note to pitch-gate.
2026-11-13 Drop boat-mount package; tighten Insitu and Sears writeups.
2026-11-13 Add cleaned actuator part selection and motor curves to pitch-stabilization.
2026-11-13 Move pitch sim PNGs into experiments/; drop empty figures/.
2026-11-13 Move pitch gate code under design/pitch-gate; drop rail-design-review.pdf.
2026-11-13 Note actuator sizing review in pitch-stabilization README.
